wolvineers/eurobot_2025_SIMA_PCB/README.md

# eurobot_2025_SIMA_PCB
Repository of the eurobot 2025 SIMA's PCB
