wolvineers/eurobot_2025_SIMA_PCB/Llibreries/RNW0013A.stp

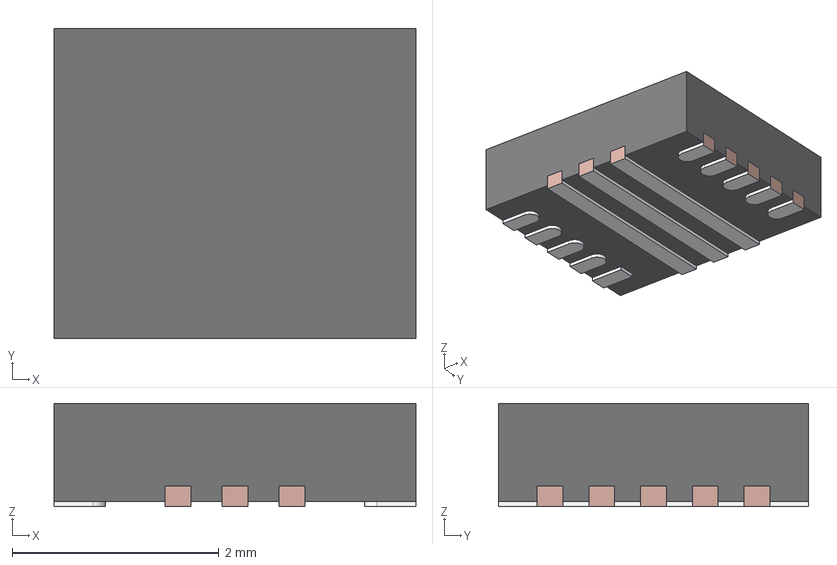
[picture p1: CAD file, 2025-01-25]
Llibreries/RNW0013A.stp
3.50 x 3.00 x 1.00 mm
BODY-SON
FRAME-RNW0013A
PIN1-ID
