wolvineers/eurobot_2025_SIMA_PCB/Llibreries/ul_DRV8876PWPR/PWP0016C.stp

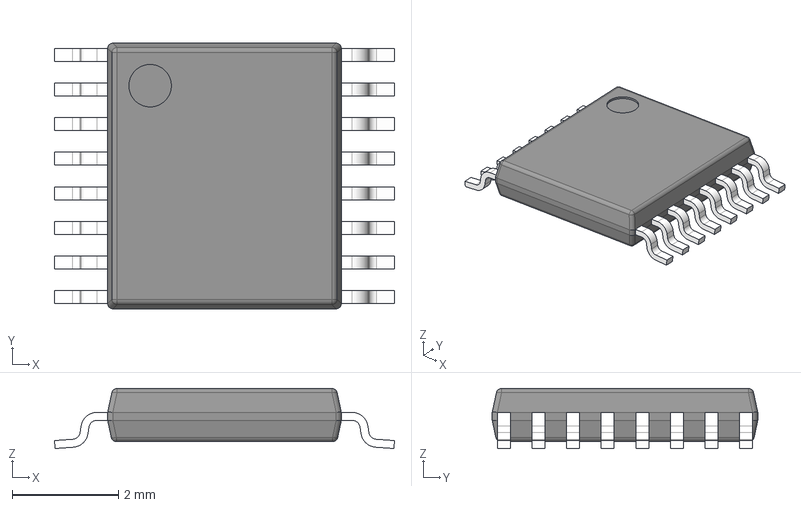
[picture p2: CAD file, 2025-01-25]
Llibreries/ul_DRV8876PWPR/PWP0016C.stp
6.40 x 5.00 x 1.13 mm
BODY-TSSOP
LEAD-TSSOP x 16
PIN1
DAP
