wolvineers/eurobot_2025_SIMA_PCB/SIMAs.step

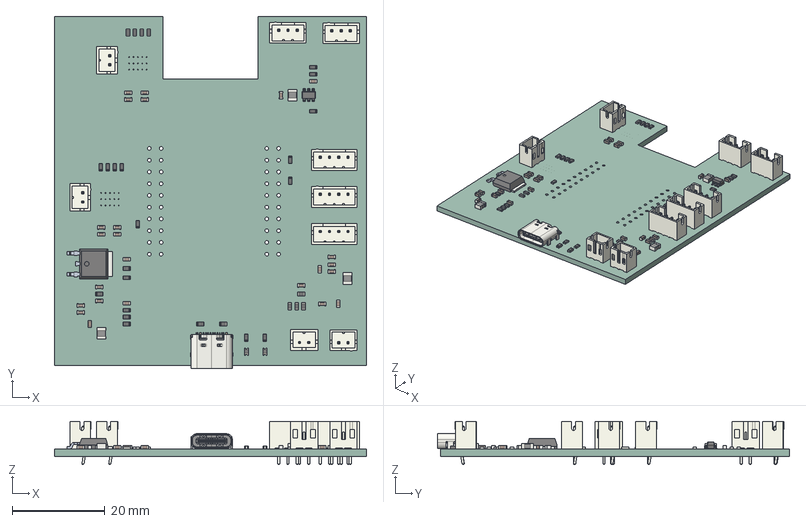
[picture p3: CAD file, 2025-02-08]
SIMAs.step
67.5 x 76.1 x 9.40 mm
R_0603_1608Metric x 28
L_1008_2520Metric x 3
C_0603_1608Metric x 24
JST_B3B_PH_K x 2
USB_C_Receptacle_16P_TopMnt_Horizontal_GCT_USB4105-xx-A
JST_B2B_PH_K x 4
JST_B4B_PH_K x 3
D_0603 x 2
CQ assembly
SOT_23_6
SIMAs_PCB
