wolvineers/eurobot_2025_SIMA_PCB/SIMAs.kicad_pcb

## KiCad design SIMAs.kicad_pcb (2025-03-23)

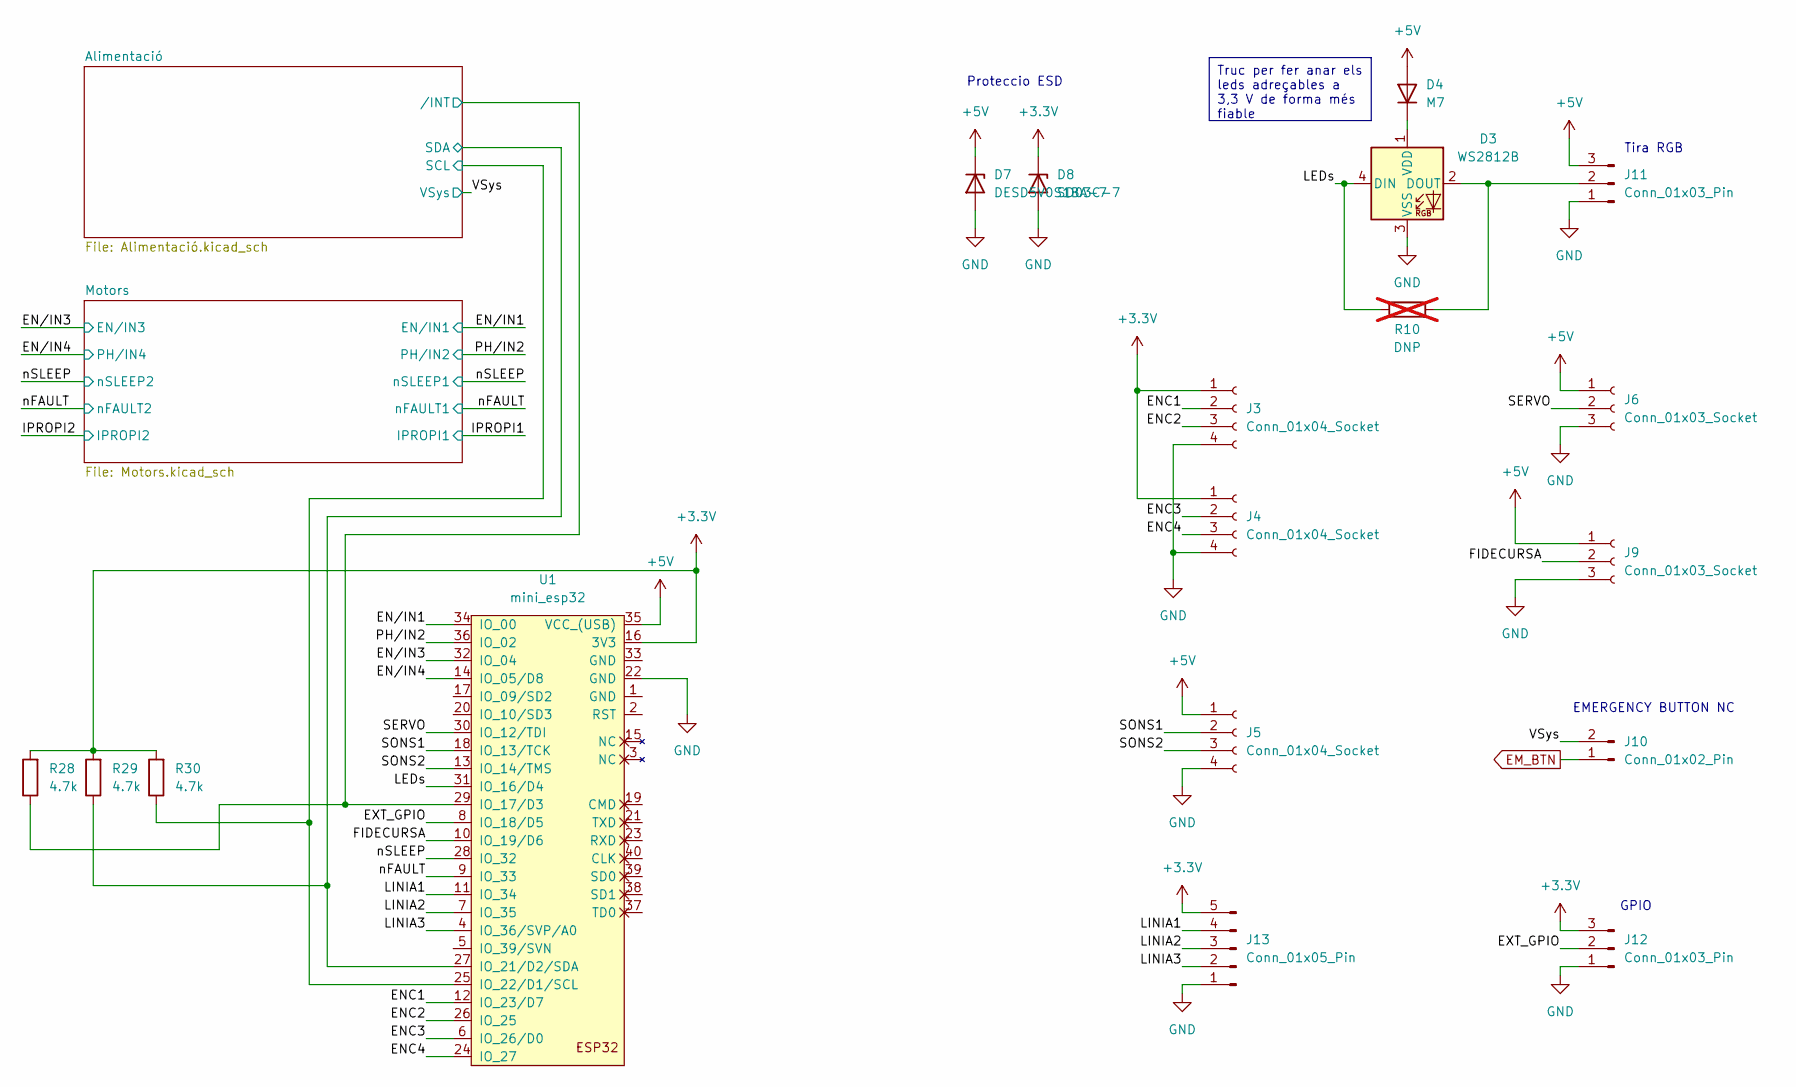
[picture p4: schematic SIMAs.kicad_sch]

Parts:
D3: WS2812B; LED_WS2812B_PLCC4_5.0x5.0mm_P3.2mm
D4: M7; D_SMA_Handsoldering
D7: DESD5V0S1BA-7; D_SOD-323
D8: SD03C-7; D_SOD-323
J3, J4, J5: Conn_01x04_Socket; JST_PH_B4B-PH-K_1x04_P2.00mm_Vertical
J6, J9: Conn_01x03_Socket; JST_PH_B3B-PH-K_1x03_P2.00mm_Vertical
J10: Conn_01x02_Pin; JST_PH_B2B-PH-K_1x02_P2.00mm_Vertical
J11, J12: Conn_01x03_Pin; JST_PH_B3B-PH-K_1x03_P2.00mm_Vertical
J13: Conn_01x05_Pin; JST_PH_B5B-PH-K_1x05_P2.00mm_Vertical
R10: DNP; R_0603_1608Metric; not fitted
R28, R29, R30: 4.7k; R_0603_1608Metric
U1: mini_esp32; ESP32_mini

Connections:
+3.3V: D8.1 (K), J3.1, J4.1, J12.3, J13.5, R28.2, R29.2, R30.2, U1.16 (3V3)
+5V: D4.2 (A), D7.1 (K), J5.1, J6.1, J9.1, J11.3, U1.35 (VCC_(USB)); also elsewhere on the board
/Alimentació/SCL: R30.1, U1.25 (IO_22/D1/SCL); also elsewhere on the board
/Alimentació/SDA: R29.1, U1.27 (IO_21/D2/SDA); also elsewhere on the board
/Alimentació//INT: R28.1, U1.29 (IO_17/D3); also elsewhere on the board
/ENC1: J3.2, U1.12 (IO_23/D7)
/ENC2: J3.3, U1.26 (IO_25)
/ENC3: J4.2, U1.6 (IO_26/D0)
/ENC4: J4.3, U1.24 (IO_27)
/EN/IN1: U1.34 (IO_00); also elsewhere on the board
/EN/IN3: U1.32 (IO_04); also elsewhere on the board
/EN/IN4: U1.14 (IO_05/D8); also elsewhere on the board
/EXT_GPIO: J12.2, U1.8 (IO_18/D5)
/FIDECURSA: J9.2, U1.10 (IO_19/D6)
/LEDs: D3.4 (DIN), R10.1, U1.31 (IO_16/D4)
/LINIA1: J13.4, U1.11 (IO_34)
/LINIA2: J13.3, U1.7 (IO_35)
/LINIA3: J13.2, U1.4 (IO_36/SVP/A0)
/PH/IN2: U1.36 (IO_02); also elsewhere on the board
/SERVO: J6.2, U1.30 (IO_12/TDI)
/SONS1: J5.2, U1.18 (IO_13/TCK)
/SONS2: J5.3, U1.13 (IO_14/TMS)
/VSys: J10.2; also elsewhere on the board
/nFAULT: U1.9 (IO_33); also elsewhere on the board
/nSLEEP: U1.28 (IO_32); also elsewhere on the board
EM_BTN: J10.1; also elsewhere on the board
GND: D3.3 (VSS), D7.2 (A), D8.2 (A), J3.4, J4.4, J5.4, J6.3, J9.3, J11.1, J12.1, J13.1, U1.22 (GND); also elsewhere on the board
unnamed: D3.2 (DOUT), J11.2, R10.2
unnamed: D3.1 (VDD), D4.1 (K)

Notes on the sheet:
Truc per fer anar els leds adreçables a 3,3 V de forma més fiable
EMERGENCY BUTTON NC
GPIO
Tira RGB
Proteccio ESD

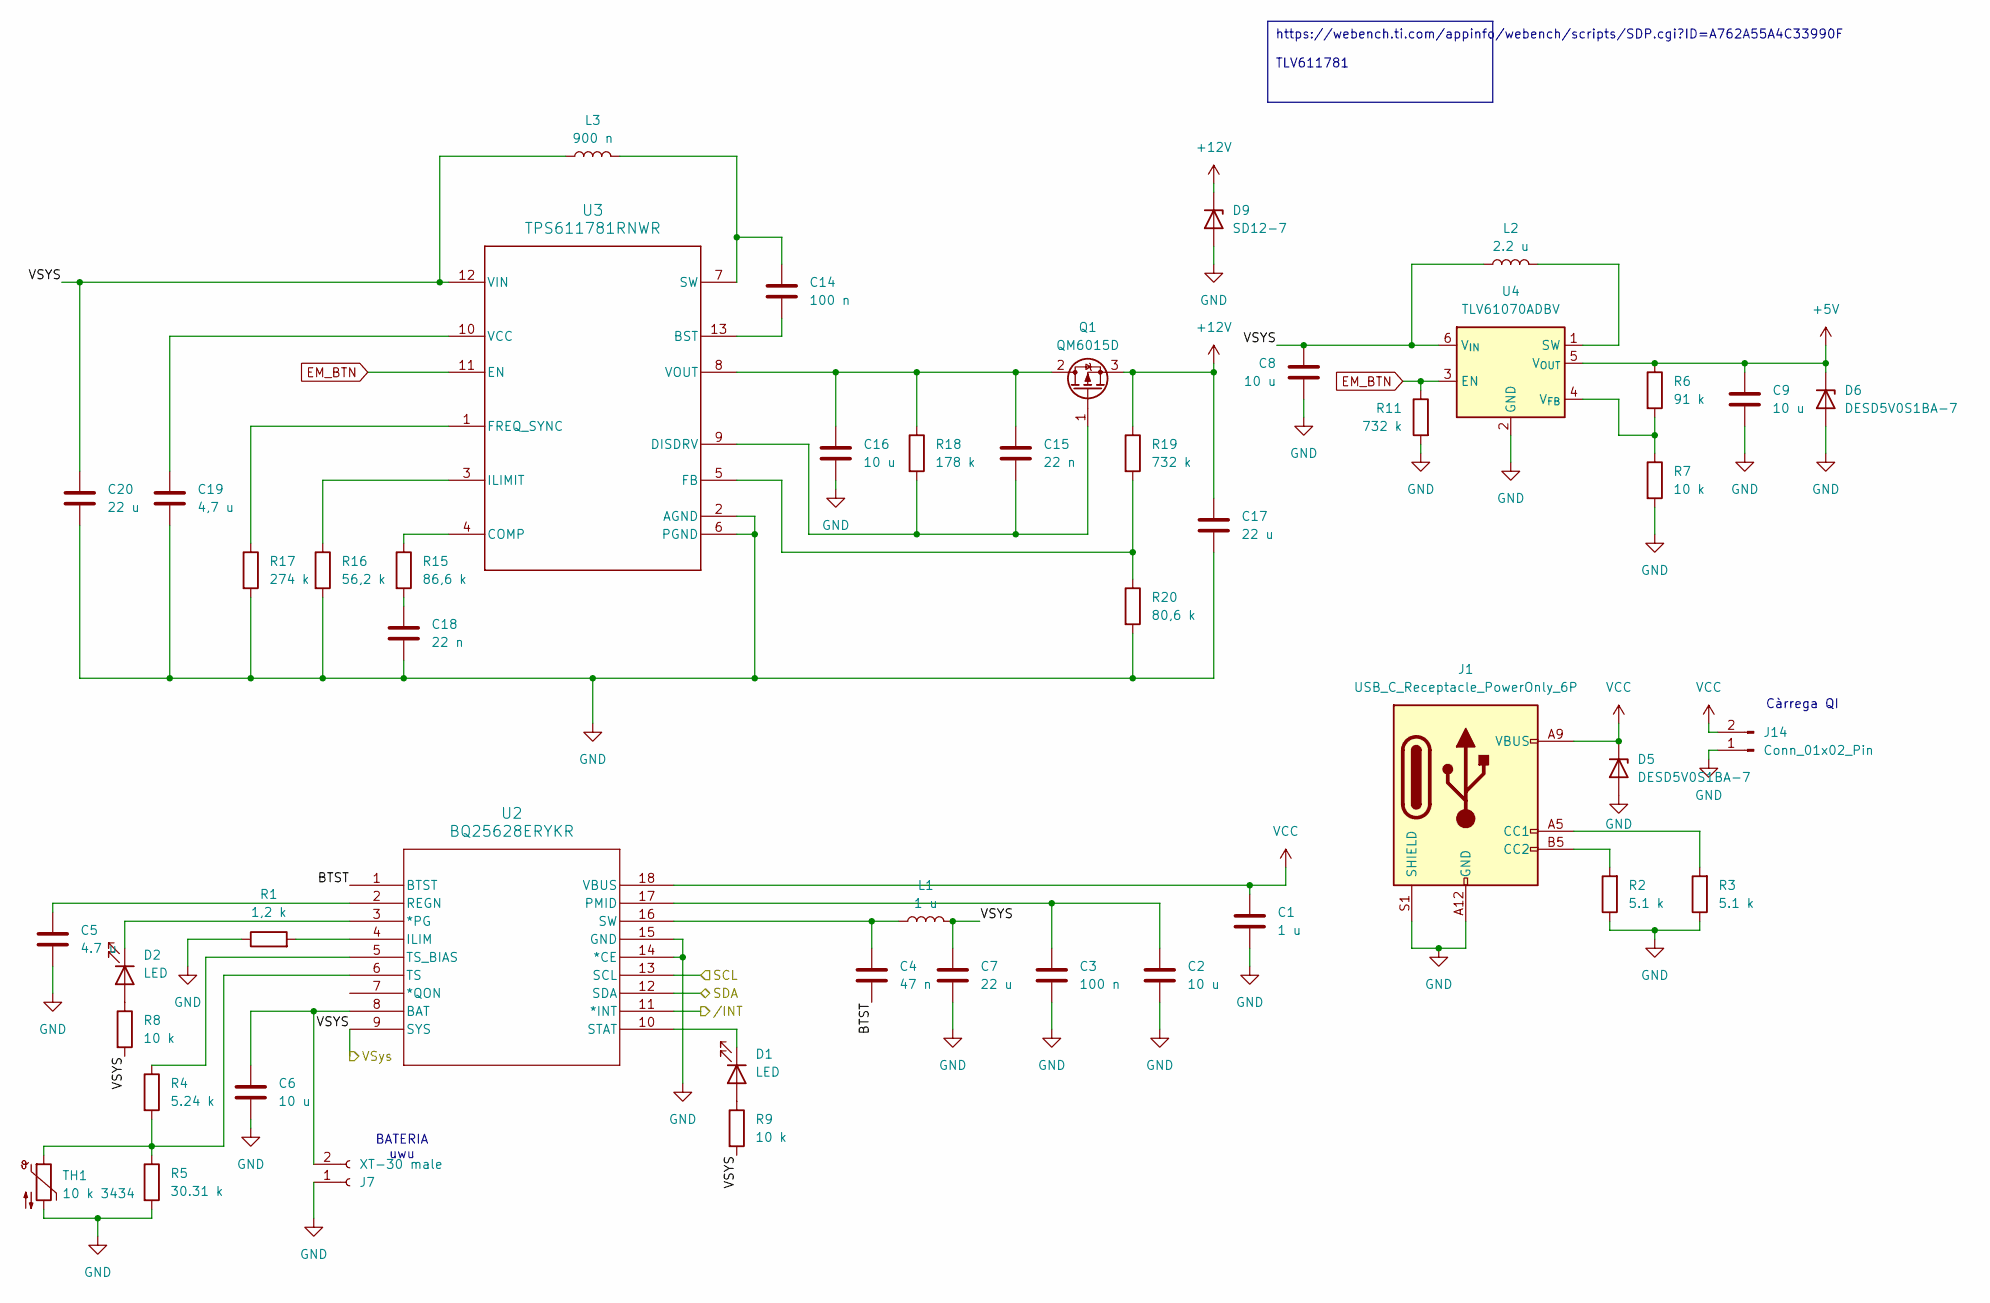
[picture p5: schematic Alimentació.kicad_sch]

Parts:
C1: 1 u; C_0603_1608Metric_Pad1.08x0.95mm_HandSolder
C2, C6, C8, C9, C16: 10 u; C_0603_1608Metric_Pad1.08x0.95mm_HandSolder
C3, C14: 100 n; C_0603_1608Metric_Pad1.08x0.95mm_HandSolder
C4: 47 n; C_0603_1608Metric_Pad1.08x0.95mm_HandSolder
C5: 4.7 u; C_0603_1608Metric_Pad1.08x0.95mm_HandSolder
C7, C17, C20: 22 u; C_0603_1608Metric_Pad1.08x0.95mm_HandSolder
C15, C18: 22 n; C_0603_1608Metric_Pad1.08x0.95mm_HandSolder
C19: 4,7 u; C_0603_1608Metric_Pad1.08x0.95mm_HandSolder
D1, D2: LED; D_0603_1608Metric
D5, D6: DESD5V0S1BA-7; D_SOD-323
D9: SD12-7; D_SOD-323
J1: USB_C_Receptacle_PowerOnly_6P; USB_C_6_DEALON
J7: XT-30 male; AMASS_XT30U-M_1x02_P5.0mm_Vertical
J14: Conn_01x02_Pin; JST_PH_B2B-PH-K_1x02_P2.00mm_Vertical
L1: 1 u; L_1008_2520Metric_Pad1.43x2.20mm_HandSolder
L2: 2.2 u; L_1008_2520Metric_Pad1.43x2.20mm_HandSolder
L3: 900 n; L_1008_2520Metric_Pad1.43x2.20mm_HandSolder
Q1: QM6015D; TO-252-2
R1: 1,2 k; R_0603_1608Metric
R2, R3: 5.1 k; R_0603_1608Metric
R4: 5.24 k; R_0603_1608Metric
R5: 30.31 k; R_0603_1608Metric
R6: 91 k; R_0603_1608Metric
R7, R8, R9: 10 k; R_0603_1608Metric
R11, R19: 732 k; R_0603_1608Metric
R15: 86,6 k; R_0603_1608Metric
R16: 56,2 k; R_0603_1608Metric
R17: 274 k; R_0603_1608Metric
R18: 178 k; R_0603_1608Metric
R20: 80,6 k; R_0603_1608Metric
TH1: 10 k 3434; R_0603_1608Metric_Pad0.98x0.95mm_HandSolder
U2: BQ25628ERYKR; WQFN-HR18__RYK_TEX
U3: TPS611781RNWR; RNW0013A
U4: TLV61070ADBV; SOT-23-6

Connections:
+5V: C9.1, D6.1 (K), R6.1, U4.5 (V_{OUT}); also elsewhere on the board
+12V: C17.1, D9.1 (K), Q1.3 (S), R19.1; also elsewhere on the board
/Alimentació/BTST: C4.2, U2.1 (BTST)
/Alimentació/SCL: U2.13 (SCL); also elsewhere on the board
/Alimentació/SDA: U2.12 (SDA); also elsewhere on the board
/Alimentació//INT: U2.11 (*INT); also elsewhere on the board
/VSys: C7.1, C8.1, C20.1, L1.2, L2.1, L3.1, R8.2, R9.2, U2.9 (SYS), U3.12 (VIN), U4.6 (V_{IN}); also elsewhere on the board
EM_BTN: R11.1, U3.11 (EN), U4.3 (EN); also elsewhere on the board
GND: C1.1, C2.2, C3.2, C5.2, C6.2, C7.2, C8.2, C9.2, C16.2, C17.2, C18.2, C19.2, C20.2, D5.2 (A), D6.2 (A), D9.2 (A), J1.A12 (GND), J1.B12 (GND), J1.S1 (SHIELD), J7.1, J14.1, R1.1, R2.1, R3.1, R5.2, R7.2, R11.2, R16.2, R17.2, R20.2, TH1.2, U2.14 (*CE), U2.15 (GND), U3.2 (AGND), U3.6 (PGND), U4.2 (GND); also elsewhere on the board
unnamed: C18.1, R15.2
unnamed: D1.2 (A), R9.1
unnamed: D1.1 (K), U2.10 (STAT)
unnamed: D2.2 (A), R8.1
unnamed: D2.1 (K), U2.3 (*PG)
unnamed: J1.A5 (CC1), R3.2
unnamed: J1.B5 (CC2), R2.2
unnamed: C6.1, J7.2, U2.8 (BAT)
unnamed: C15.1, C16.1, Q1.2 (D), R18.1, U3.8 (VOUT)
unnamed: C15.2, Q1.1 (G), R18.2, U3.9 (DISDRV)
unnamed: R1.2, U2.4 (ILIM)
unnamed: C2.1, C3.1, U2.17 (PMID)
unnamed: C5.1, U2.2 (REGN)
unnamed: C4.1, L1.1, U2.16 (SW)
unnamed: R4.2, R5.1, TH1.1, U2.6 (TS)
unnamed: R4.1, U2.5 (TS_BIAS)
unnamed: C14.2, U3.13 (BST)
unnamed: R15.1, U3.4 (COMP)
unnamed: R19.2, R20.1, U3.5 (FB)
unnamed: R17.1, U3.1 (FREQ_SYNC)
unnamed: R16.1, U3.3 (ILIMIT)
unnamed: C14.1, L3.2, U3.7 (SW)
unnamed: C19.1, U3.10 (VCC)
unnamed: L2.2, U4.1 (SW)
unnamed: R6.2, R7.1, U4.4 (V_{FB})
VCC: C1.2, D5.1 (K), J1.A9 (VBUS), J1.B9 (VBUS), J14.2, U2.18 (VBUS)

Notes on the sheet:
https://webench.ti.com/appinfo/webench/scripts/SDP.cgi?ID=A762A55A4C33990F TLV611781
Càrrega QI
BATERIA uwu

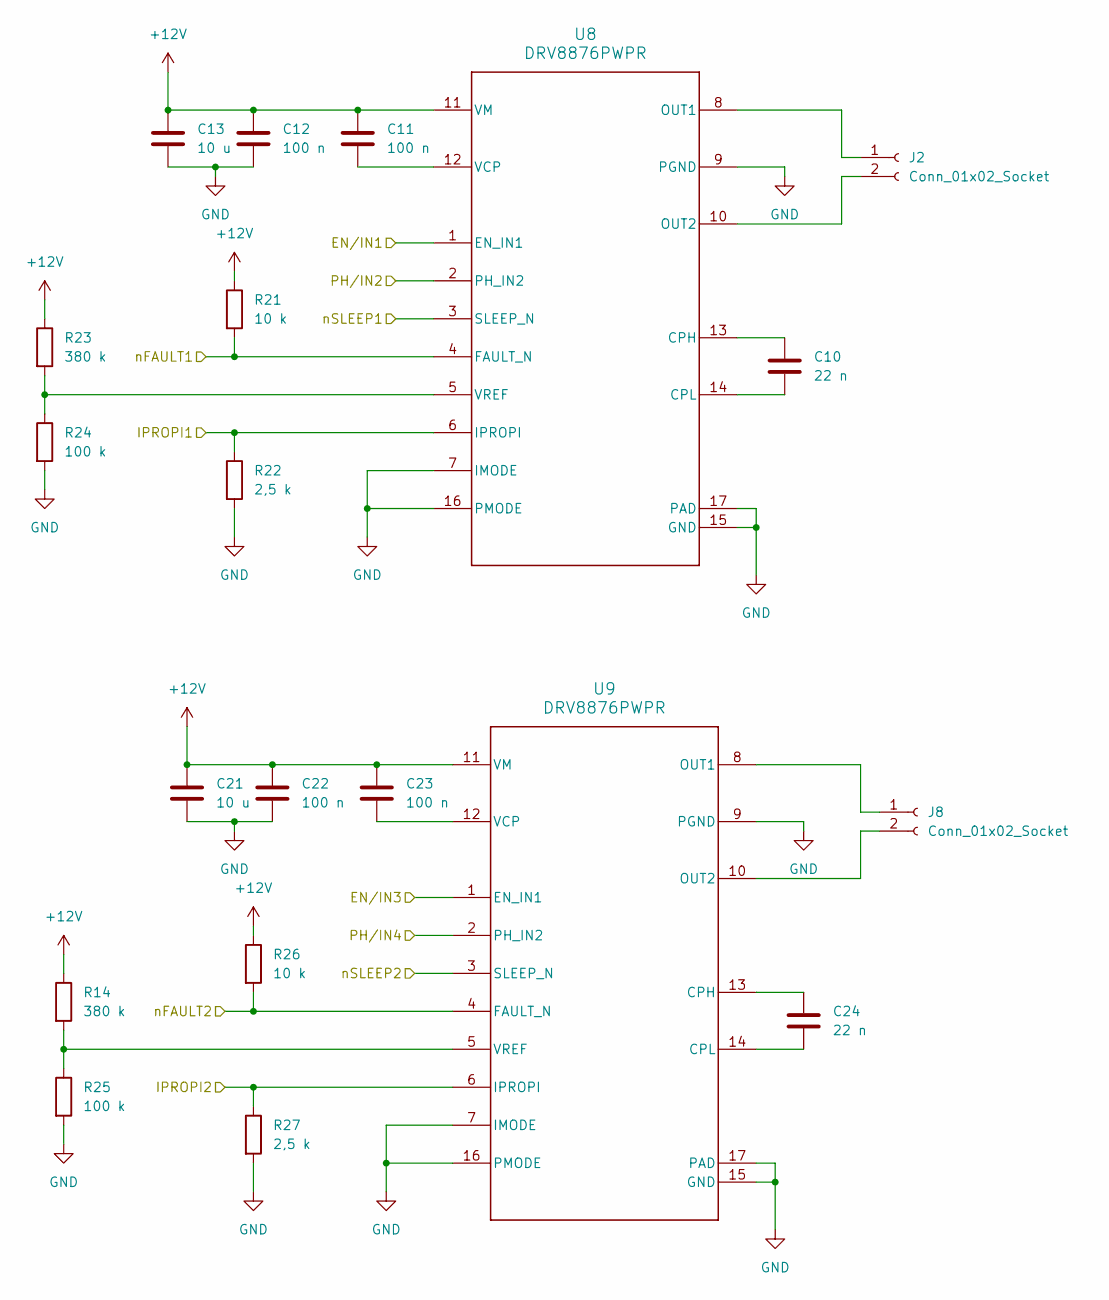
[picture p6: schematic Motors.kicad_sch]

Parts:
C10, C24: 22 n; C_0603_1608Metric_Pad1.08x0.95mm_HandSolder
C11, C12, C22, C23: 100 n; C_0603_1608Metric_Pad1.08x0.95mm_HandSolder
C13, C21: 10 u; C_0603_1608Metric_Pad1.08x0.95mm_HandSolder
J2, J8: Conn_01x02_Socket; JST_PH_B2B-PH-K_1x02_P2.00mm_Vertical
R14, R23: 380 k; R_0603_1608Metric
R21, R26: 10 k; R_0603_1608Metric
R22, R27: 2,5 k; R_0603_1608Metric
R24, R25: 100 k; R_0603_1608Metric
U8, U9: DRV8876PWPR; PWP0016J_N

Connections:
+12V: C11.2, C12.1, C13.1, C21.1, C22.1, C23.2, R14.1, R21.1, R23.1, R26.1, U8.11 (VM), U9.11 (VM); also elsewhere on the board
/EN/IN1: U8.1 (EN_IN1); also elsewhere on the board
/EN/IN3: U9.1 (EN_IN1); also elsewhere on the board
/EN/IN4: U9.2 (PH_IN2); also elsewhere on the board
/IPROPI1: R22.1, U8.6 (IPROPI)
/IPROPI2: R27.1, U9.6 (IPROPI)
/PH/IN2: U8.2 (PH_IN2); also elsewhere on the board
/nFAULT: R21.2, R26.2, U8.4 (FAULT_N), U9.4 (FAULT_N); also elsewhere on the board
/nSLEEP: U8.3 (SLEEP_N), U9.3 (SLEEP_N); also elsewhere on the board
GND: C12.2, C13.2, C21.2, C22.2, R22.2, R24.2, R25.2, R27.2, U8.7 (IMODE), U8.9 (PGND), U8.15 (GND), U8.16 (PMODE), U8.17 (PAD), U9.7 (IMODE), U9.9 (PGND), U9.15 (GND), U9.16 (PMODE), U9.17 (PAD); also elsewhere on the board
unnamed: J2.1, U8.8 (OUT1)
unnamed: J2.2, U8.10 (OUT2)
unnamed: J8.1, U9.8 (OUT1)
unnamed: J8.2, U9.10 (OUT2)
unnamed: C10.1, U8.13 (CPH)
unnamed: C10.2, U8.14 (CPL)
unnamed: C11.1, U8.12 (VCP)
unnamed: R23.2, R24.1, U8.5 (VREF)
unnamed: C24.1, U9.13 (CPH)
unnamed: C24.2, U9.14 (CPL)
unnamed: C23.1, U9.12 (VCP)
unnamed: R14.2, R25.1, U9.5 (VREF)

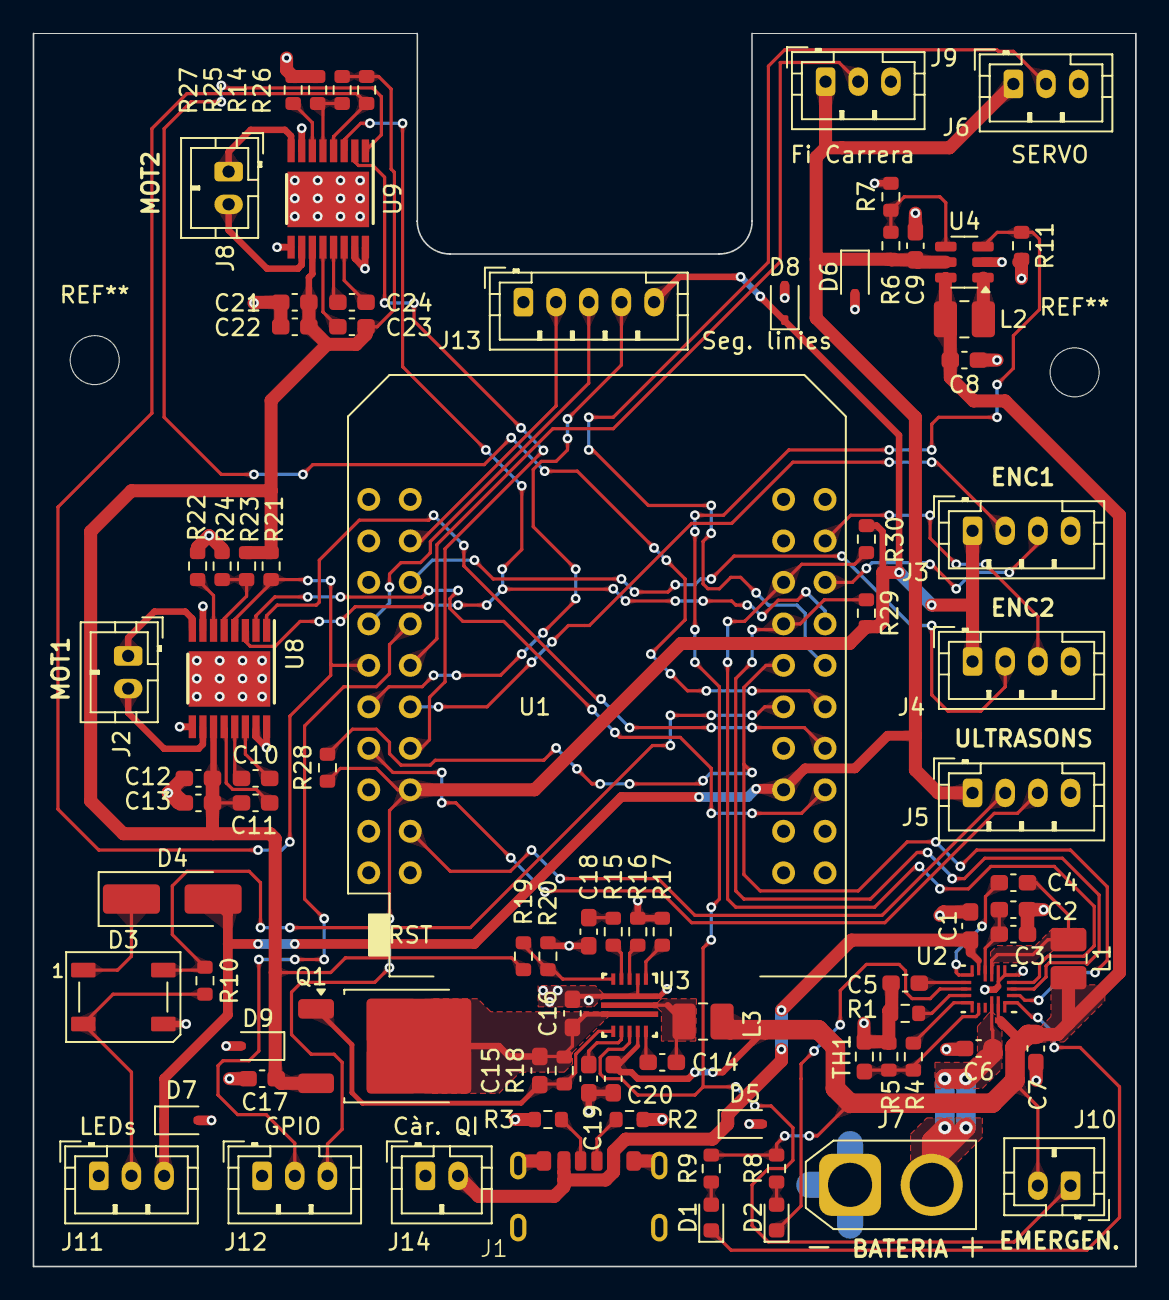
[picture p7: board SIMAs.kicad_pcb from above]

Board: 2 copper layers, 67.5 x 75.5 mm, 86 parts (0 on the bottom side), 71 nets.
