wolvineers/eurobot_2025_SIMA_PCB/(commit log)

2025-01-25 actualitzar pcb main
    [PWP0016C.stp, RNW0013A.stp]
2025-02-08 Versió 1.0, inicial
    Versió 1.0, inicial, de la placa, amb els fitxers de producció.
    [Alimentació.kicad_sch, Motors.kicad_sch, SIMAs.kicad_pcb, SIMAs.kicad_sch, SIMAs.step, bom.csv, designators.csv, positions.csv]
2025-02-21 Actualitzats valors dels components
    S'han actualitzat els valors de components d'acord als comprats, s'ha canviat algun valor per conveniència, i s'ha acabat de donar valors a tots els components
    [Alimentació.kicad_sch, Motors.kicad_sch, SIMAs.kicad_sch]
2025-03-23 S'ha actualitzat la pcb amb els nous valors
    S'ha incorporat a la pcb els canvis anteriors a l'esquemàtic, i s'ha regenerat l'ibom.
    [SIMAs.kicad_pcb]
2025-03-23 Nou esquemàtic
    Nou esquemàtic per bateria en sèrie de dues cèl·les, boost de 12 V extern, i buck de 5 V.
    [Alimentació.kicad_sch, SIMAs.kicad_sch]
